Edward1304/Digital-Desing/Hardware/Bicycle_Project/Project Outputs for Bicycle_Project/BOM/Bicycle_Project.xlsx

Description | Designator | Manufacturer | Manufacturer Part Number | Supplier 1 | Supplier Part Number 1 | Usage | Quantity
2A 1 100mΩ 60Ω@100MHz ±25% 0603 Ferrite Beads ROHS | FB400, FB402, FB403 | TAI-TECH | HCB1608KF-600T20 | LCSC | C369516 | NM | 3
RES SMD 3k3 OHM 5% 1/10W 0603 | R305 | FOJAN | FRC0603J332 TS | LCSC | C2907140 | NM | 1
-30℃~+85℃ RGB 110° 3535(mm) Light Emitting Diodes (LED) ROHS | D400, D401 | Foshan NationStar Optoelectronics | RS-3535MWAM | LCSC | C842778 |  | 2
2A 1 100mΩ 60Ω@100MHz ±25% 0603 Ferrite Beads ROHS | FB100, FB200, FB300, FB301, FB401, FB404, FB405 | TAI-TECH | HCB1608KF-600T20 | LCSC | C369516 |  | 7
2POS 5MM | J201 | JILN | JL126-50002G01 | LCSC | C394556 |  | 1
6.3V 22uF X5R ±20% 0805 Multilayer Ceramic Capacitors MLCC - SMD/SMT ROHS | C100, C211 | Samsung Electro-Mechanics | CL21A226MQQNNNE | LCSC | C5674 |  | 2
10V 10uF X5R ±10% 0603 Multilayer Ceramic Capacitors MLCC - SMD/SMT ROHS | C105, C210, C300, C303 | CCTC | TCC0603X5R106K100CT | LCSC | C380314 |  | 4
50V 1uF X5R ±10% 0603 Multilayer Ceramic Capacitors MLCC - SMD/SMT ROHS | C400, C401, C402 | Samsung Electro-Mechanics | CL10A105KB8NNNC | LCSC | C15849 |  | 3
50V 100nF Y5V -20%~+80% 0603 Multilayer Ceramic Capacitors MLCC - SMD/SMT ROHS | C101, C102, C103, C104, C301, C302, C304 | Walsin Tech Corp | 0603F104Z500CT | LCSC | C83060 |  | 7
CONN PWR JACK 2X5.5MM SOLDER | J202 | HCTL | HC-DC-005-2.0T | LCSC | C3010533 |  | 1
CONN RCPT USB2.0 MINI B SMD R/A | J200 | EDAC Inc. | KH-MINI-SMT-5P-Cu | LCSC | C2688795 |  | 1
DIODE SCHOTTKY 40V 1A SOD123F | D200, D202, D203 | Shanghai Prisemi Elec | PSBD1DF40V1H | LCSC | C110730 |  | 3
IC FLASH 16M SPI 85MHZ 8SOP | U302 | Zetta | ZD25WQ16BTIGR | LCSC | C2896790 |  | 1
IC MCU 32BIT 64KB FLASH 48LQFP | U100 | STMicroelectronics | STM32F030C8T6TR | LCSC | C23922 |  | 1
IC USB TO UART BRIDGE QFN20 | U300 | Silicon Labs | CP2102N-A02-GQFN20R | LCSC | C969913 |  | 1
LED GREEN CLEAR 0805 SMD | D301 | XINGLIGHT | XL-2012UGC | LCSC | C965815 |  | 1
LED RED CLEAR 0805 SMD | D201, D204, D300, D402 | XINGLIGHT | XL-2012SURC | LCSC | C965812 |  | 4
MOSFET N-CH 20V SOT23 | Q400, Q401, Q402, Q403, Q404, Q405, Q406, Q407 | Doeshare | DN2302S | LCSC | C2931750 |  | 8
RES SMD 1k OHM 5% 1/10W 0603 | R403, R404, R405, R409, R414, R415, R416, R420, R421, R422, R428 | FOJAN | FRC0603J102 TS | LCSC | C2907113 |  | 11
RES SMD 4k7 OHM 5% 1/10W 0603 | R426 | FOJAN | FRC0603J472 TS | LCSC | C2907166 |  | 1
RES SMD 5k1 OHM 5% 1/10W 0603 | R101, R300 | FOJAN | FRC0603J512 TS | LCSC | C2907114 |  | 2
RES SMD 10k OHM 5% 1/10W 0603 | R100, R102, R301, R304, R306, R307, R308, R309, R310, R311, R406, R407, R408, R410, R417, R418, R419, R423, R424, R425, R429 | FOJAN | FRC0603J103TS | LCSC | C2930027 |  | 21
RES SMD 24R OHM 5% 1/10W 0603 | R401, R412 | FOJAN | FRC0603J240 TS | LCSC | C2907132 |  | 2
RES SMD 30R OHM 1% 1/10W 0603 | R402, R413 | FOJAN | FRC0603F30R0TS | LCSC | C2907026 |  | 2
RES SMD 33R OHM 5% 1/10W 0603 | R303 | FOJAN | FRC0603J330 TS | LCSC | C2907154 |  | 1
RES SMD 52R3 OHM 1% 1/10W 0603 | R400, R411 | FOJAN | FRC0603F52R3TS | LCSC | C2998074 |  | 2
RES SMD 100R OHM 5% 1/10W 0603 | R201, R302, R427 | FOJAN | FRC0603J101 TS | LCSC | C2907089 |  | 3
RES SMD 220R OHM 5% 1/10W 0603 | R200 | FOJAN | FRC0603J221 TS | LCSC | C2907127 |  | 1
SWITCH TACTILE SPST-NO 0.05A 12V | SW100, SW400, SW401, SW402 | BZCN | TSC015A05026A | LCSC | C2888509 |  | 4
TVS DIODE 5.25V 17V SOT23-6 | U301 | STMicroelectronics | USBLC6-2SC6 | LCSC | C7519 |  | 1
1A 60dB@(120Hz) Fixed 3.3V Positive 18V SOT-223 Linear Voltage Regulators (LDO) ROHS | U200 | UMW(Youtai Semiconductor Co., Ltd.) | AMS1117-3.3 | LCSC | C347222 |  | 1
CONN HEADER VERT 2POS 2.54MM | J400 | Amphenol ICC (FCI) | 10129378-902001BLF | Digi-Key | 10129378-902001BLF-ND |  | 1
CONN HEADER VERT 3POS 2.54MM | J402 | Amphenol ICC (FCI) | 10129378-903001BLF | Digi-Key | 10129378-903001BLF-ND |  | 1
CONN HEADER VERT 4POS 2.54MM | J401 | Amphenol ICC (FCI) | 10129378-904001BLF | Digi-Key | 10129378-904001BLF-ND |  | 1
CONN HEADER VERT 5POS 2.54MM | J100 | Amphenol ICC (FCI) | 10129378-905001BLF | Digi-Key | 10129378-905001BLF-ND |  | 1
CONN HEADER VERT 24POS 2.54MM | J203 | Amphenol ICC (FCI) | 10129381-924001BLF | Digi-Key | 10129381-924001BLF-ND |  | 1
