Edward1304/Digital-Desing/(list of files, drawings)

Other design files:
Hardware/Bicycle_Project/Bicycle_Project1/Bicycle_Project.PcbLib
Hardware/Bicycle_Project/Bicycle_Project1/Bicycle_Project.SCHLIB
Hardware/Bicycle_Project/Bicycle_Project.PcbDoc
Hardware/Bicycle_Project/Bicycle_Project.PrjPcb
Hardware/Bicycle_Project/INPUTS_OUTPUTS.SchDoc
Hardware/Bicycle_Project/MCU.SchDoc
Hardware/Bicycle_Project/Power.SchDoc
Hardware/Bicycle_Project/Project Outputs for Bicycle_Project/Altium/Bicycle_Project.PcbDoc
Hardware/Bicycle_Project/Project Outputs for Bicycle_Project/Altium/Bicycle_Project.PrjPcb
Hardware/Bicycle_Project/Project Outputs for Bicycle_Project/Altium/Communication.SchDoc
Hardware/Bicycle_Project/Project Outputs for Bicycle_Project/Altium/INPUTS_OUTPUTS.SchDoc
Hardware/Bicycle_Project/Project Outputs for Bicycle_Project/Altium/main.SchDoc
Hardware/Bicycle_Project/Project Outputs for Bicycle_Project/Altium/MCU.SchDoc
Hardware/Bicycle_Project/Project Outputs for Bicycle_Project/Altium/Power.SchDoc
Hardware/Library (E, G)/Bicycle_project.PcbLib
Hardware/Library (E, G)/Bicycle_project.SchLib
Hardware/Library (E, G)/shared_lib/shared_lib.PcbLib
Hardware/Library (E, G)/shared_lib/shared_lib.SchLib
