Edward1304/Digital-Desing/Firmware/Bicycle_Project/Core/Inc/Temperature_functions.h

/*
 * Temperature_functions.h
 *
 *  Created on: Oct 5, 2024
 *      Author: PISSO
 */

#ifndef INC_TEMPERATURE_FUNCTIONS_H_
#define INC_TEMPERATURE_FUNCTIONS_H_

#include "main.h"


#endif /* INC_TEMPERATURE_FUNCTIONS_H_ */
