Edward1304/Digital-Desing/Firmware/Prueba_FLASH/Core/Src/main.c

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
/* Includes ------------------------------------------------------------------*/
#include "main.h"

/* USER CODE BEGIN Includes */
#include "Flash.h"
#include <string.h>
#include <stdio.h>
/* USER CODE END Includes */

SPI_HandleTypeDef hspi1;

TIM_HandleTypeDef htim3;

/* USER CODE BEGIN PV */
uint8_t transmit_text[ 64 ];
extern uint8_t read_flash_Byte[ 255 ];
volatile uint8_t address_to_write[3] ;
uint8_t things_to_write[255];
/* USER CODE END PV */

void SystemClock_Config(void);
static void MX_GPIO_Init(void);
static void MX_SPI1_Init(void);
static void MX_TIM3_Init(void);
/**
  * @brief  The application entry point.
  * @retval int
  */
int main(void)
{

  /* MCU Configuration--------------------------------------------------------*/

  /* Reset of all peripherals, Initializes the Flash interface and the Systick. */
  HAL_Init();

  /* Configure the system clock */
  SystemClock_Config();

  /* Initialize all configured peripherals */
  MX_GPIO_Init();
  MX_SPI1_Init();
  MX_TIM3_Init();
  /* USER CODE BEGIN 2 */
  //HAL_TIM_Base_Start(&htim2);
  //flash_csn(1);

  HAL_TIM_Base_Start_IT(&htim3);
  DS18B20_Init(htim3, DS18B20_GPIO_Port, DS18B20_Pin);

  /* USER CODE END 2 */

  /* Infinite loop */
  /* USER CODE BEGIN WHILE */

  Flash_read_identification_id();
  Flash_activate_deactivate_block_protect();
  uint8_t status_reg1;
  uint8_t status_reg2;
  uint8_t status_reg3;

  Flash_read_status1_register( &status_reg1 );
  Flash_read_status2_register( &status_reg2 );
  Flash_read_status3_register( &status_reg3 );

  Flash_read_page(0x00, 0x01, 0x00, 255);
  Flash_sector_erase(0x00, 0x01, 0x02);
  Flash_read_page(0x00, 0x01, 0x00, 255);
  uint8_t size_to_send;
  size_to_send = sprintf( &things_to_write, "the temperature is: %d \r\n", 30 );
  Flash_write_page( 0x00, 0x01, 0x02 , &things_to_write[0] , 255 );
  Flash_read_page(0x00, 0x01, 0x02, 255);
  Flash_read_page(0x00, 0x01, 0x02, 255);
 /* uint8_t Presence;
  uint8_t Temp_byte1;
  uint8_t Temp_byte2;
  uint8_t size_to_send;
  float temp_dec;

  memset(&read_flash_Byte, 0x00,255);
  Flash_activate_write();
  Flash_read_status_register_2();
  Flash_read_status_register_3();
  Flash_read_identification_id();
  size_to_send = sprintf( &transmit_text, "id read: %d \r\n", read_flash_Byte[0] );
  HAL_UART_Transmit(&huart2, &transmit_text, size_to_send, 1000);

  memset(&things_to_write, 0x00,255);
  address_to_write[0] = 0x00;
  address_to_write[2] = 0x02;
  Flash_read_page(0x00, 0x01, 0x02, 255);
  Flash_block_erase(0x00, 0x01, 0x02);
  //erase_all();
  HAL_Delay(100);

  memset(&things_to_write, 0x20,255);
  Flash_read_identification_id();
  Flash_write_page( 0x00, 0x01, 0x02 , &things_to_write[0] , 255 );
  HAL_Delay(100);
  Flash_read_identification_id();
  Flash_read_page(0x00, 0x01, 0x02, 255);
  Flash_block_erase(0x00, 0x01, 0x02);
  HAL_Delay(100);
  size_to_send = sprintf( &things_to_write, "the temperature is: %d \r\n", 30 );
 // memset(&things_to_write, 0x30,255);
  Flash_write_page(0x00, 0x01, 0x02 , &things_to_write[0] , 255 );
  HAL_Delay(100);
  Flash_read_page(0x00, 0x01, 0x02, 255);
  size_to_send = sprintf( &transmit_text, "value read: %c \r\n", read_flash_Byte[0] );
  HAL_UART_Transmit(&huart2, &transmit_text, size_to_send, 1000);
  HAL_Delay(1000);
*/

  while (1)
  {
	  // program to read the temperature
	  /*
	  Presence = DS18B20_Start();
	  HAL_Delay (1);
	  DS18B20_Write (0xCC);  // skip ROM
	  DS18B20_Write (0x44);  // convert t
	  HAL_Delay (800);

	  Presence = DS18B20_Start ();
	  HAL_Delay(1);
	  DS18B20_Write (0xCC);  // skip ROM
	  DS18B20_Write (0xBE);  // Read Scratch-pad

	  Temp_byte1 = DS18B20_Read();
	  Temp_byte2 = DS18B20_Read();
	  HAL_UART_Transmit(&huart2, "read", 4, 1000);
	  size_to_send = sprintf( &transmit_text, "presence %d el primer %d y el segundo %d \r\n", Presence,Temp_byte1,Temp_byte2);
	  HAL_UART_Transmit(&huart2, &transmit_text, size_to_send, 1000);
	  temp_dec = convert_temperature(Temp_byte1 , Temp_byte2);
	  size_to_send = sprintf( &transmit_text, "result temperature %f \r\n", temp_dec );
	  HAL_UART_Transmit(&huart2, &transmit_text, size_to_send, 1000);
*/

    /* USER CODE END WHILE */

    /* USER CODE BEGIN 3 */
  }
  /* USER CODE END 3 */
}

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
