Edward1304/Digital-Desing/(commit log)

2024-03-01 Creación de Librería
2024-03-15 advance design schematic
    [Bicycle_Project.PrjPcb, Bicycle_project.PcbLib, Bicycle_project.SchLib, Communication.SchDoc, MCU.SchDoc, Power.SchDoc, main.SchDoc, shared_lib.PcbLib]
2024-03-16 Avance en esquemático
    [Bicycle_Project.PrjPcb, Communication.SchDoc, MCU.SchDoc, Power.SchDoc, main.SchDoc]
2024-03-16 modify schematic MCU sensors
    [MCU.SchDoc]
2024-03-17 Esquemático finalizado - Pendiente de revisiones
    [Bicycle_Project.PrjPcb, Communication.SchDoc, INPUTS_OUTPUTS.SchDoc, MCU.SchDoc, Power.SchDoc, main.SchDoc]
2024-03-18 finishe schematic /init PCB
    [Bicycle_Project.PcbDoc, Bicycle_Project.PrjPcb, Communication.SchDoc, INPUTS_OUTPUTS.SchDoc, MCU.SchDoc, Power.SchDoc, main.SchDoc]
2024-03-19 Modificación de resistencias GATE-MOSFETs y resistencias de WP y HOLD de memoria FLASH
    [Bicycle_Project.PcbDoc, Communication.SchDoc, INPUTS_OUTPUTS.SchDoc, MCU.SchDoc, Power.SchDoc]
2024-03-20 Pull-up de sensor de temperatura
    [Bicycle_Project.PcbDoc, INPUTS_OUTPUTS.SchDoc]
2024-03-22 location PCB components
    [Bicycle_Project.PcbDoc, Communication.SchDoc, INPUTS_OUTPUTS.SchDoc, Power.SchDoc]
2024-03-22 solucionar problemas usb-pd-pn
    [Bicycle_Project.PcbDoc, Communication.SchDoc, Power.SchDoc]
2024-03-22 Cambio de coneción en bus de datos USB
    [Bicycle_Project.PcbDoc, Communication.SchDoc]
2024-03-23 progress review
    [Bicycle_Project.PcbDoc, Bicycle_Project.PrjPcb, Communication.SchDoc, INPUTS_OUTPUTS.SchDoc, MCU.SchDoc, Power.SchDoc]
2024-03-24 Actualización esquemático
    [Bicycle_Project.PcbDoc, Communication.SchDoc, INPUTS_OUTPUTS.SchDoc, MCU.SchDoc, Power.SchDoc, shared_lib.PcbLib, shared_lib.SchLib]
2024-03-24 Actualización PCB
    [Bicycle_Project.PcbDoc, Bicycle_Project.PrjPcb, Communication.SchDoc, INPUTS_OUTPUTS.SchDoc, MCU.SchDoc, Power.SchDoc, main.SchDoc]
2024-03-25 Actualización de PCB
    [Bicycle_Project.PcbDoc, Communication.SchDoc, INPUTS_OUTPUTS.SchDoc, MCU.SchDoc, shared_lib.PcbLib, shared_lib.SchLib]
2024-03-25 full labeled design
    [Bicycle_Project.PcbDoc]
2024-03-26 Se agregó header con GPIOs libres
    [Bicycle_Project.PcbDoc, INPUTS_OUTPUTS.SchDoc, MCU.SchDoc, Power.SchDoc, main.SchDoc, shared_lib.PcbLib, shared_lib.SchLib]
2024-04-02 modife labels PCB /schematic
    [Bicycle_Project.PcbDoc, MCU.SchDoc, Power.SchDoc]
2024-04-04 grounds Error
    [Bicycle_Project.PcbDoc, INPUTS_OUTPUTS.SchDoc, MCU.SchDoc, Power.SchDoc, main.SchDoc]
2024-04-04 Solución de tierras desconectadas
    [Bicycle_Project.PcbDoc, MCU.SchDoc]
2024-04-04 labels configurations PCB Bottom layer
    [Bicycle_Project.PcbDoc]
2024-04-05 Agregando LED de setting
    [Bicycle_Project.PcbDoc, Bicycle_Project.PrjPcb, INPUTS_OUTPUTS.SchDoc, MCU.SchDoc, Power.SchDoc]
2024-04-05 Bottom Overlay Ready
    [Bicycle_Project.PcbDoc]
2024-04-06 PCB finalizada, a espera de revisión de Victor
    [Bicycle_Project.PcbDoc, INPUTS_OUTPUTS.SchDoc, MCU.SchDoc]
2024-04-06 Atualización de revisión
    [Bicycle_Project.PcbDoc, INPUTS_OUTPUTS.SchDoc, main.SchDoc]
2024-04-15 created output files
    [Bicycle_Project.DRL, Bicycle_Project.GBL, Bicycle_Project.GBO, Bicycle_Project.GBP, Bicycle_Project.GBS, Bicycle_Project.GTL, Bicycle_Project.GTO, Bicycle_Project.GTP]
2024-04-16 Archivos listos para entrega de PCB
    [Bicycle_Project.DRL, Bicycle_Project.GBL, Bicycle_Project.GBO, Bicycle_Project.GBP, Bicycle_Project.GBS, Bicycle_Project.GTL, Bicycle_Project.GTO, Bicycle_Project.GTP]
2024-07-29 Inicio de modificación de headers
    [Bicycle_Project.PcbDoc, Bicycle_project.PcbLib, Bicycle_project.SchLib, Power.SchDoc]
2024-08-02 Problema al agregar nuevos header
    [Bicycle_Project.PcbDoc, Bicycle_Project.PcbLib, Bicycle_Project.SCHLIB, Bicycle_project.SchLib, Power.SchDoc]
2024-08-03 Headers agregados correctamente
    [Bicycle_Project.PcbDoc, Bicycle_Project.PcbLib, Bicycle_Project.PrjPcb, Bicycle_Project.SCHLIB, Bicycle_project.PcbLib, Bicycle_project.SchLib, INPUTS_OUTPUTS.SchDoc, MCU.SchDoc]
2024-08-04 PCB finalizada
    [Bicycle_Project.PcbDoc]
2024-08-04 update file to send / error header temp
    [Bicycle_Project.PcbDoc, Bicycle_Project.PrjPcb, Bicycle_Project.xlsx, INPUTS_OUTPUTS.SchDoc, MCU.SchDoc, Power.SchDoc]
2024-08-04 Error header corregido. PCB finalizada
    [Bicycle_Project.PcbDoc, Bicycle_project.PcbLib, Bicycle_project.SchLib, INPUTS_OUTPUTS.SchDoc]
2024-08-04 file to send delivery
    [Bicycle_Project.PcbDoc, Bicycle_Project.PrjPcb, Bicycle_Project.xlsx, INPUTS_OUTPUTS.SchDoc]
2024-09-03 Iniciando tarea del 7 de septiembre - agregando tren al semáforo
2024-09-25 sensor speed library
2024-10-03 Requerimiento 1,2 y 6 completamente funcionales. El requerimiento 7 está pendiente de guardar en la flash, pero ya hace el promedio
