Edward1304/Digital-Desing/(notices)

Notices in the files:
Firmware/Bicycle_Project/Core/Inc/main.h:
Copyright (c) 2024 STMicroelectronics.
All rights reserved.
This software is licensed under terms that can be found in the LICENSE file
Firmware/Prueba_FLASH/Core/Src/main.c:
Copyright (c) 2022 STMicroelectronics.
